thesocrdu/emb_sys_lab/final_documentation/images/ground_station.jpg

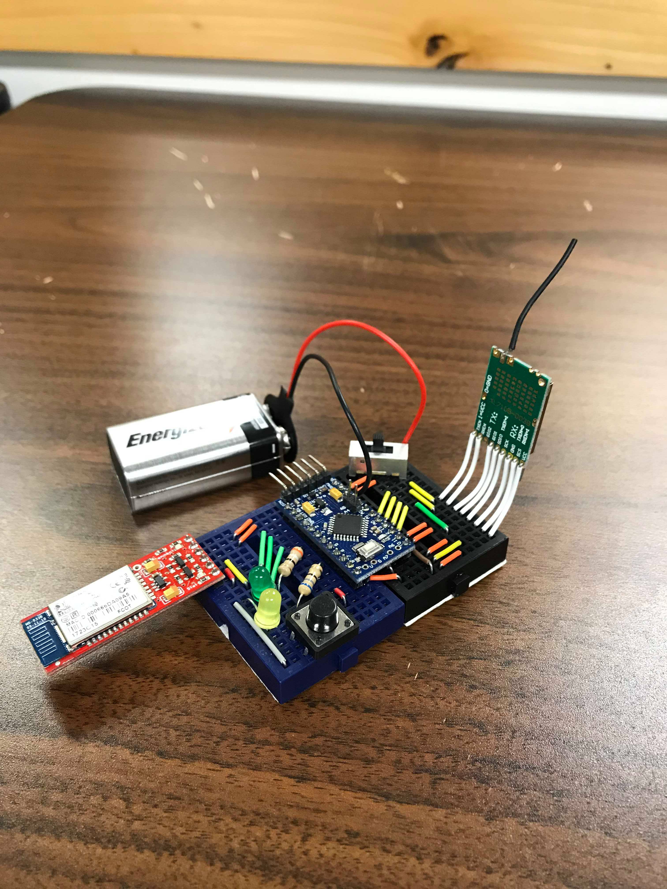
final_documentation/images/ground_station.jpg
