thesocrdu/emb_sys_lab/final_documentation/images/classic_controller.jpg

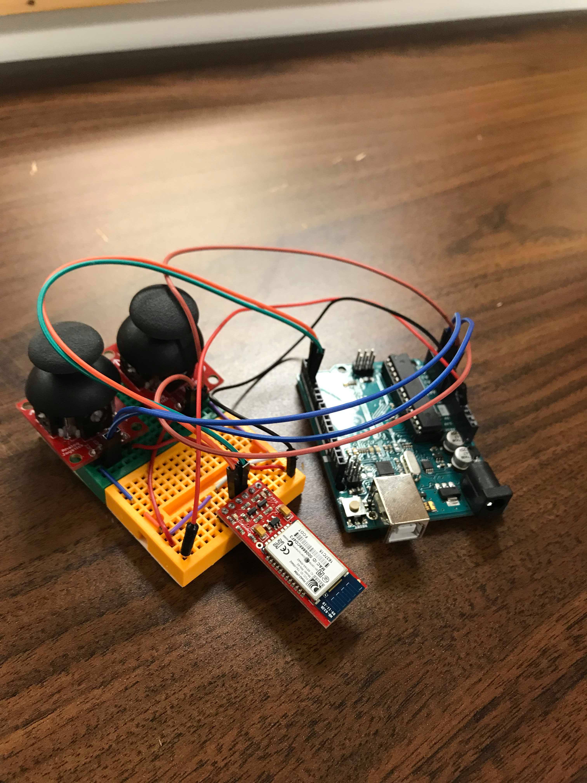
final_documentation/images/classic_controller.jpg
