thesocrdu/emb_sys_lab/final_documentation/final_updated_diagrams.pptx

Ground Station

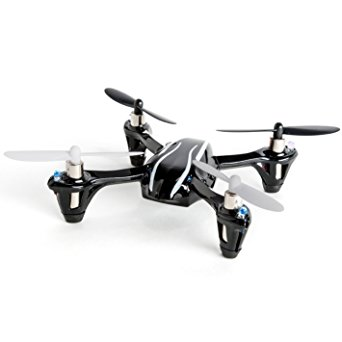
[picture p3: figure]
Image result for hubsan x4

## Slide 2

ATmega328P (3.3V | 8 MHz)

Ground Station

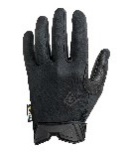
[picture p4: figure]
Image result for glove

…

QoBUP

Bluetooth
Receiver

UART
(RX/TX)
115200 baud

3.3V

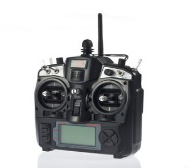
[picture p5: figure]
Image result for rc controller

QoBUP

2
/

Bind LED

RST

Quad LED
Btn

Quad
LED State

Hubsan X4 (H107L)

A7105 2.4 GHz Receiver
(Hubsan X4 H107L)

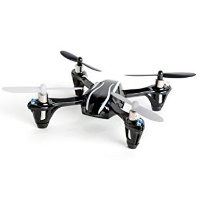
[picture p6: figure]
Image result for hubsan x4

Bluetooth UART Interface

Protocol Parser

3.3V

Translation Layer

A7105 SPI Interface

4
/

SPI
(SCK, MISO, MOSI, SS)
8 Mbps

3.7V

Wireless
Wired

A7105
2.4 GHz Transmitter
(2.0-3.6V)
