thesocrdu/emb_sys_lab/CDR/CDR_updated_diagrams.pptx

Ground Station

Image result for hubsan x4

## Slide 2

ATmega328P (16 MHz)

SPI
(SCK, MISO, MOSI, SS)
8 Mbps

Ground Station

Image result for glove

…

QoBUP

Bluetooth
Receiver

UART
(RX/TX)
115200 baud

5V

Image result for rc controller

QoBUP

2
/

Bind LED

RST

Training Mode
Btn

Training Mode
LED

Hubsan X4 (H107L)

A7105 2.4 GHz Receiver
(Hubsan X4 H107L)

Image result for hubsan x4

Bluetooth UART Interface

Protocol Parser

3.3V

Translation Layer

A7105 SPI Interface

4
/

3.7V

Wireless
Wired

A7105
2.4 GHz Transmitter
(2.0-3.6V)

4
/

Level Shifter
5V→ 3.3V
