thesocrdu/emb_sys_lab/PDR/Block Diagram 20180208_[3015].pptx

Glove Controller

IMU
MPU-6050
(3.3-5V)

Traditional-Style Controller

Push Button 1
Scan Mode

Push Button 2
Calibration

Joystick 1

Joystick 2

Ground Station

2.4 GHz Transmitter
(2.0-3.6V)

Bluetooth
Transmitter

I²C

SoC
ATmega328

Power
3.7V LiPo Battery

Bluetooth
Transmitter

SoC
ATmega328

Power

Flex Sensor

Common Derived Protocol

Bluetooth
Receiver

Power

Common Derived Protocol

Quadcopter

2.4 GHz Receiver
(Hubsan X4 H107L)

Level Shifter
5V→ 3.3V

SoC
ATmega328P

Blue is Corrie
Green is Kyle
