thesocrdu/emb_sys_lab/final_documentation/images/glove_controller.jpg

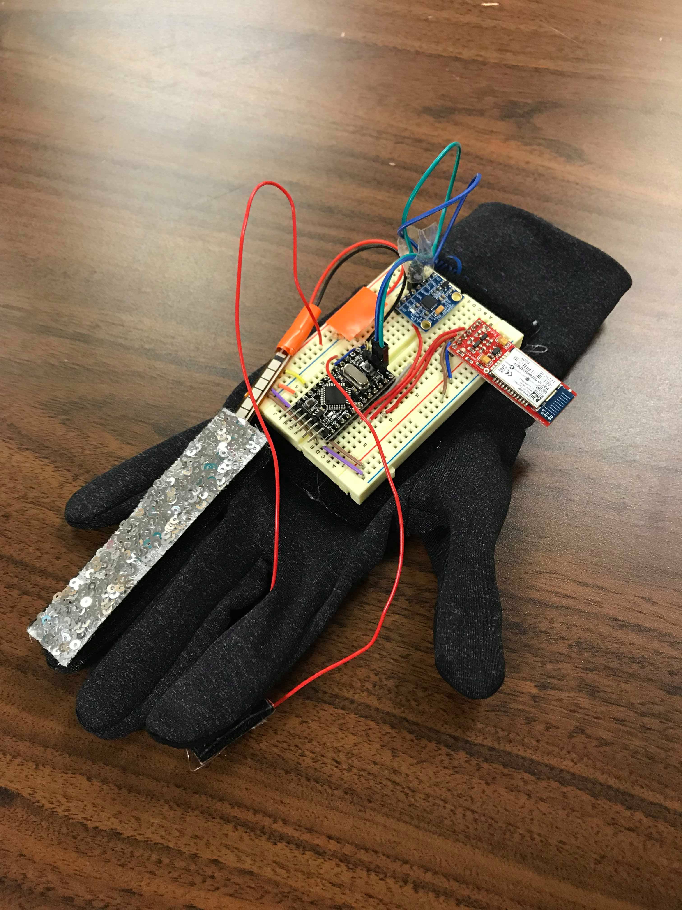
final_documentation/images/glove_controller.jpg
