thesocrdu/emb_sys_lab/final_documentation/images/overall_system.jpg

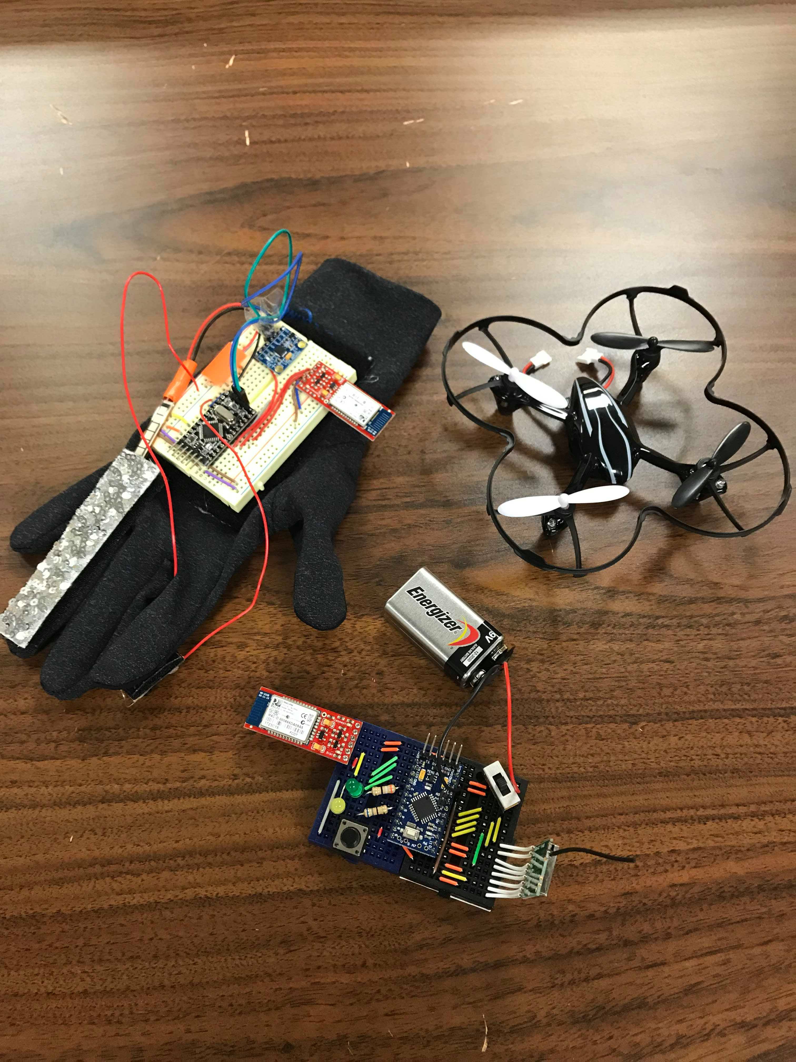
final_documentation/images/overall_system.jpg
