thesocrdu/emb_sys_lab/(list of files, drawings)

Other design files:
final_documentation/ground_station.fzz
