thesocrdu/emb_sys_lab/(commit log)

2018-02-09 Adding ref material and project_ideas.docx
2018-03-06 GS: reorganized folder structure to Arduino spec
2018-03-29 GS: Simple throttle unit test.
    Note: Be careful of Serial issues interfering
    with the setup of the RF chip. This can cause
    weird issues to crop up that you will most likely
    blame on the software :)
2018-04-04 GS: add LED control feature to Hubsan class
2018-04-12 GS: integration bugs part 1. Working sync test.
    [synchronous_gs_system_test.cpp]
2018-04-15 GS: replace A7105 init code with libHusan sample
2018-04-16 GS: Replaced binding choreography with bind() func
    [synchronous_gs_system_test.cpp]
2018-04-22 GS: add final driver program
2018-04-22 GS: add build script to wrap arduino toolchain
2018-04-28 GS: stability for non-GS_DEBUG configuration
    - Removed usage of TimerOne since SPI operations
    involve interrupt driven functions while in
    interrupt context
    - Updated "full-speed" baud for bluetooth module
    to be 57600 because according to the literature
    the RN-42 chip's serial interface runs into
    problems without hardware flow control.
    [gs_async_main.cpp]
2018-04-28 GS: add binding LED feature
    [gs_async_main.cpp]
2018-04-28 GS: add training mode button and LED
2018-04-29 GS: add TXEN pin for better TX power
2018-04-30 GS: update pins for demo board
2018-05-05 GS: mapped training button to Hubsan LEDs
2018-05-05 GS: speed up startup of SPI
2018-05-06 GS: Turn TX power to lowest on A7105
2018-05-11 Add final documentation
    [ground_station.fzz]
